hpvdt/tempest/README.md

# tempest
Collection of information on our tempest lighting system
